a7u7a/AES-Boiler/PCB/board_v1/mfg_image/Board_v1.dxf

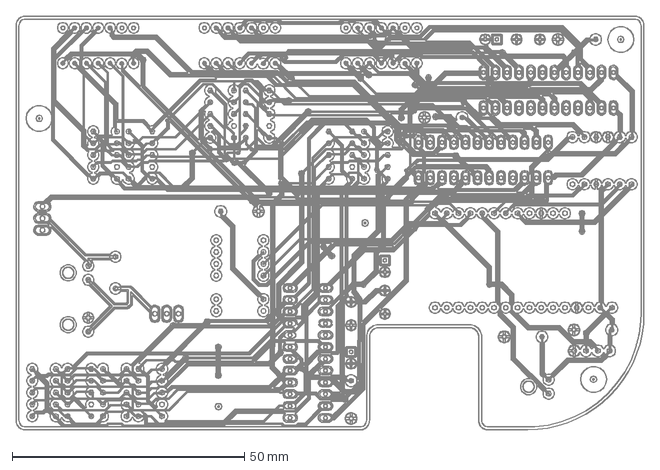
[picture p2: CAD file, 2019-01-08, an earlier design]
PCB/board_v1/mfg_image/Board_v1.dxf
135.1 x 89.0 mm
