a7u7a/AES-Boiler/PCB/board_v1/Board_v1.pdf

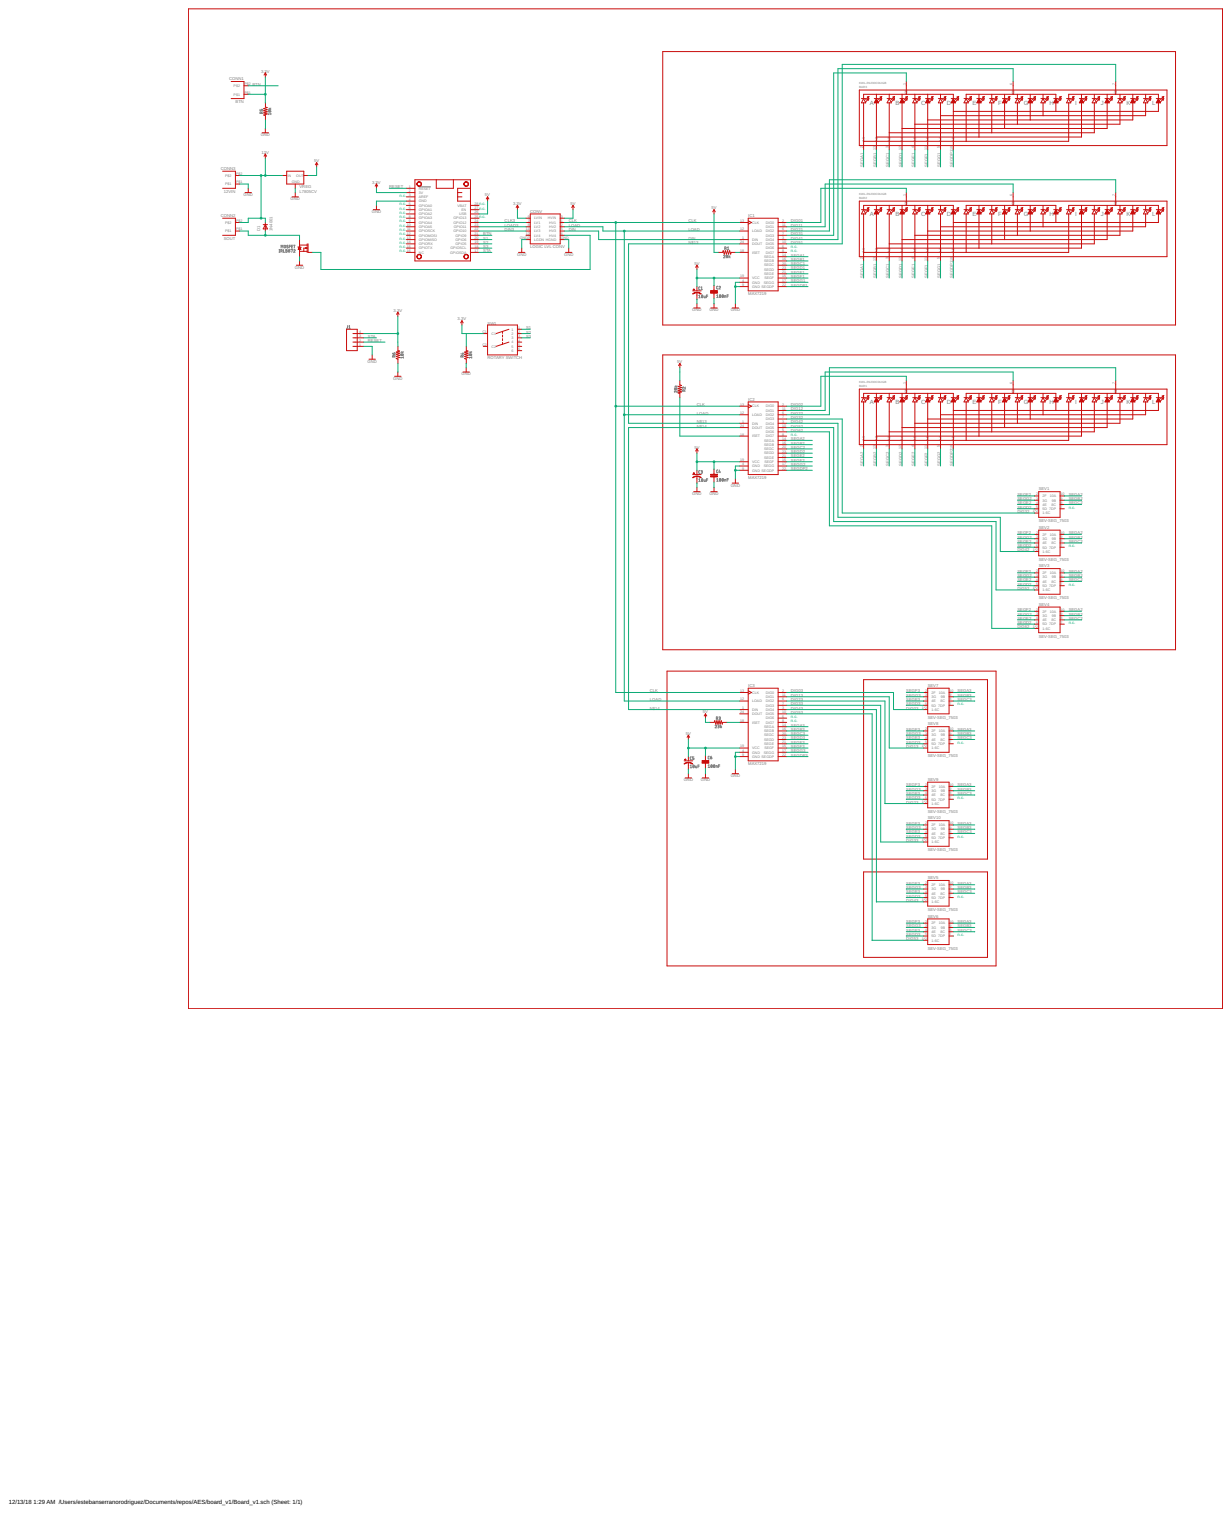
[picture p3: page 1]

N$13 | 24 | 10 DIG6 DIG51
5V | | 5 DIG7 8 SEGA 14 SEGB 16 SEGC 20 SEGD 23 SEGE 21 SEGF 15 SEGG 17 SEGDP

N$14 24 | | 10 DIG6 DIG52

18 | | 5 DIG7 DIG62

12/13/18 1:29 AM /Users/estebanserranorodriguez/Documents/repos/AES/board_v1/Board_v1.sch (Sheet: 1/1)
