a7u7a/AES-Boiler/PCB/board_v2/Board_v2.brd

## EAGLE design PCB/board_v2/Board_v2.brd (2019-01-14)

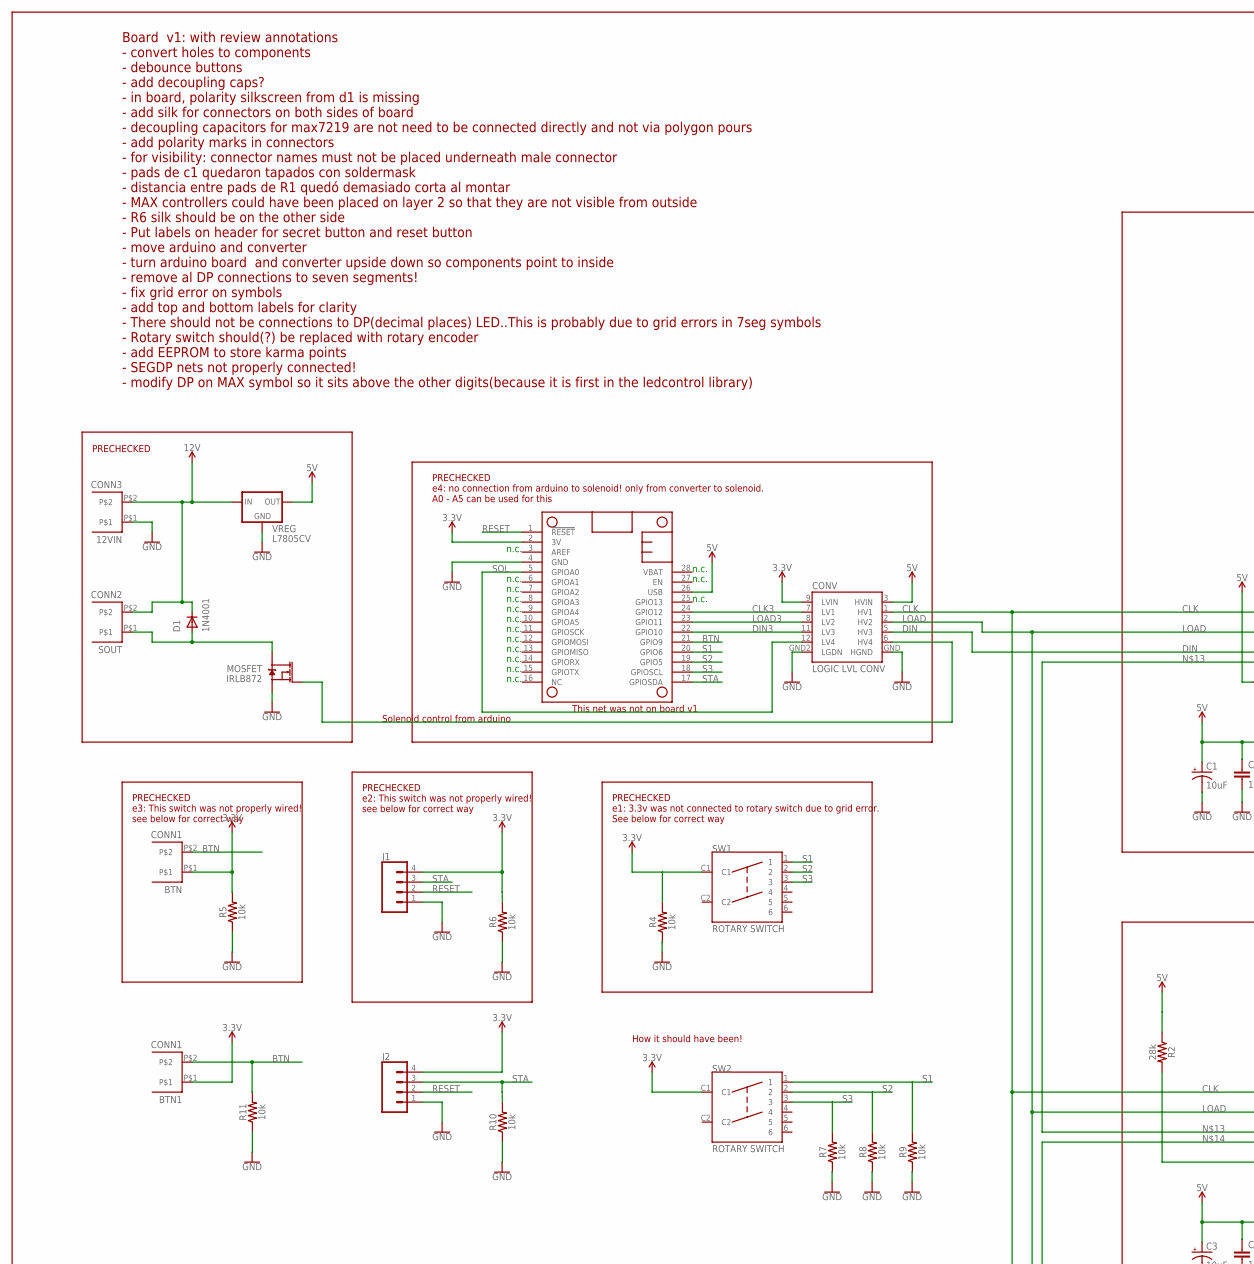
[picture p4: schematic Board_v2.sch, part in row 1, column 1]

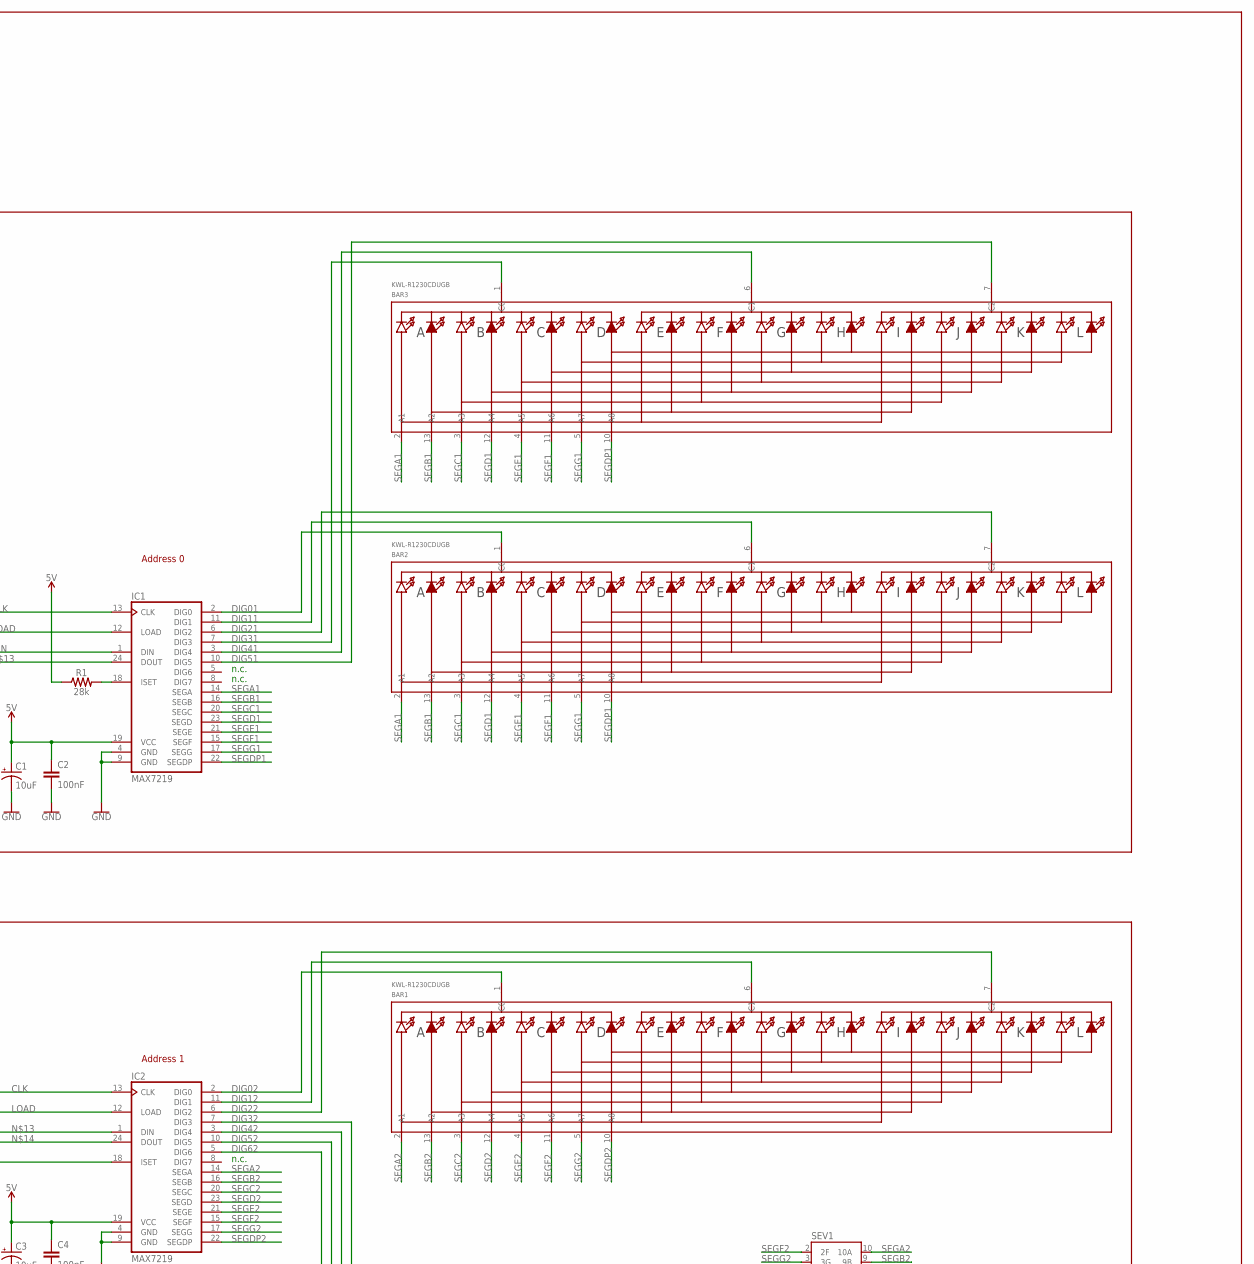
[picture p5: schematic Board_v2.sch, part in row 1, column 2]

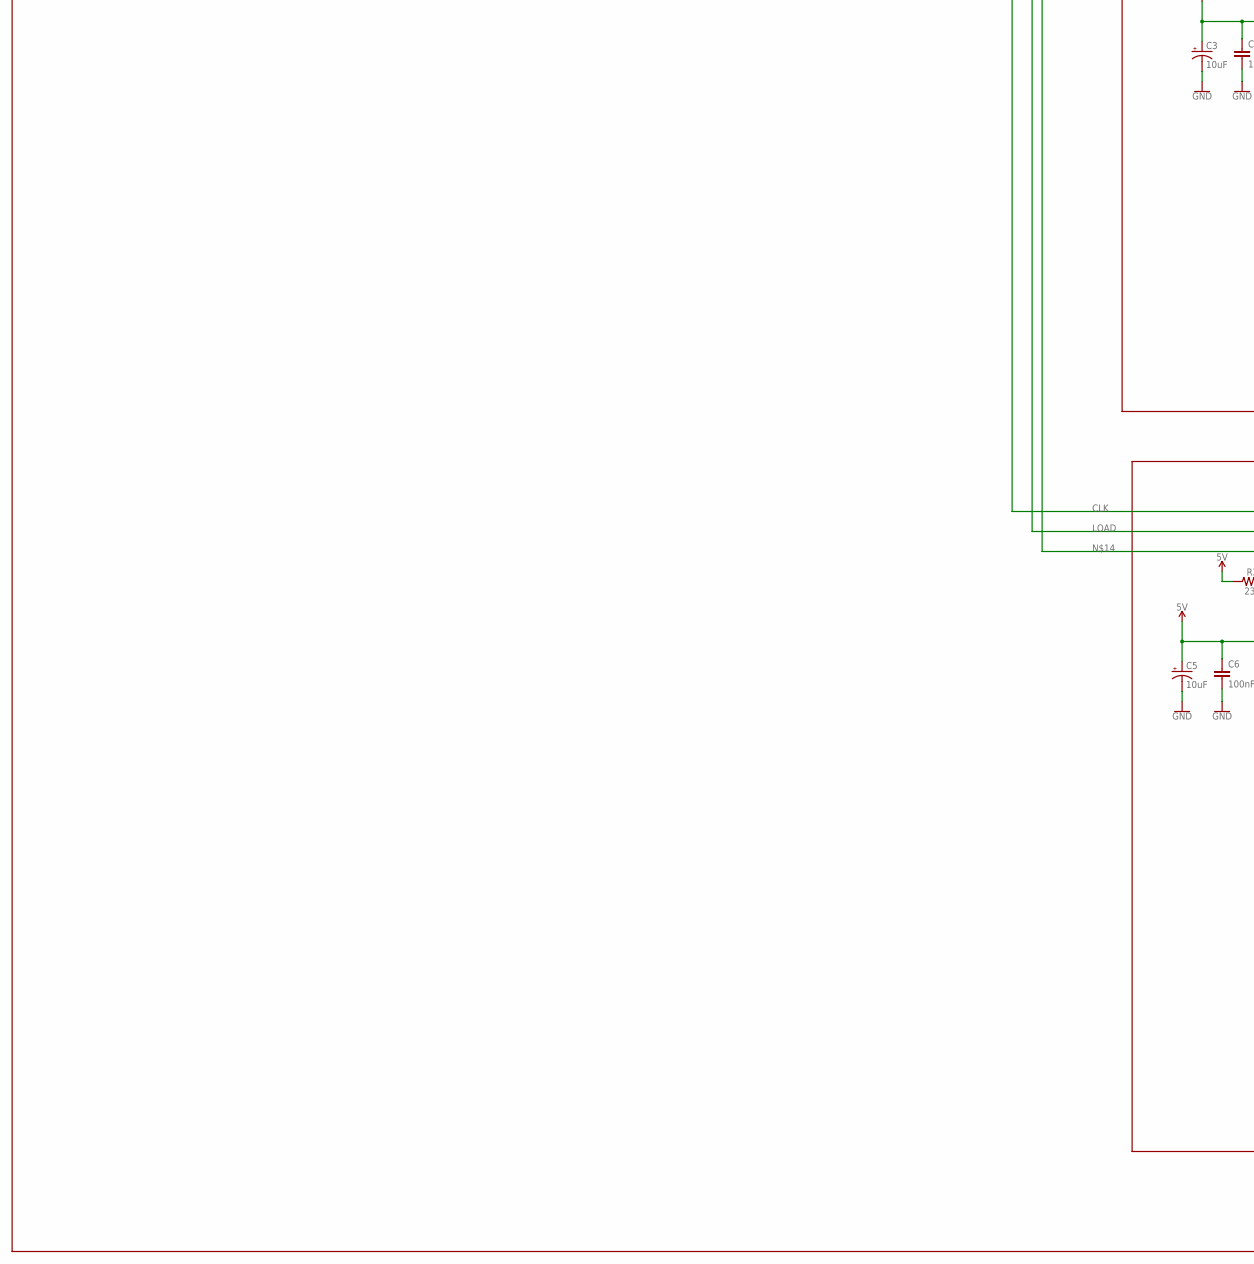
[picture p6: schematic Board_v2.sch, part in row 2, column 1]

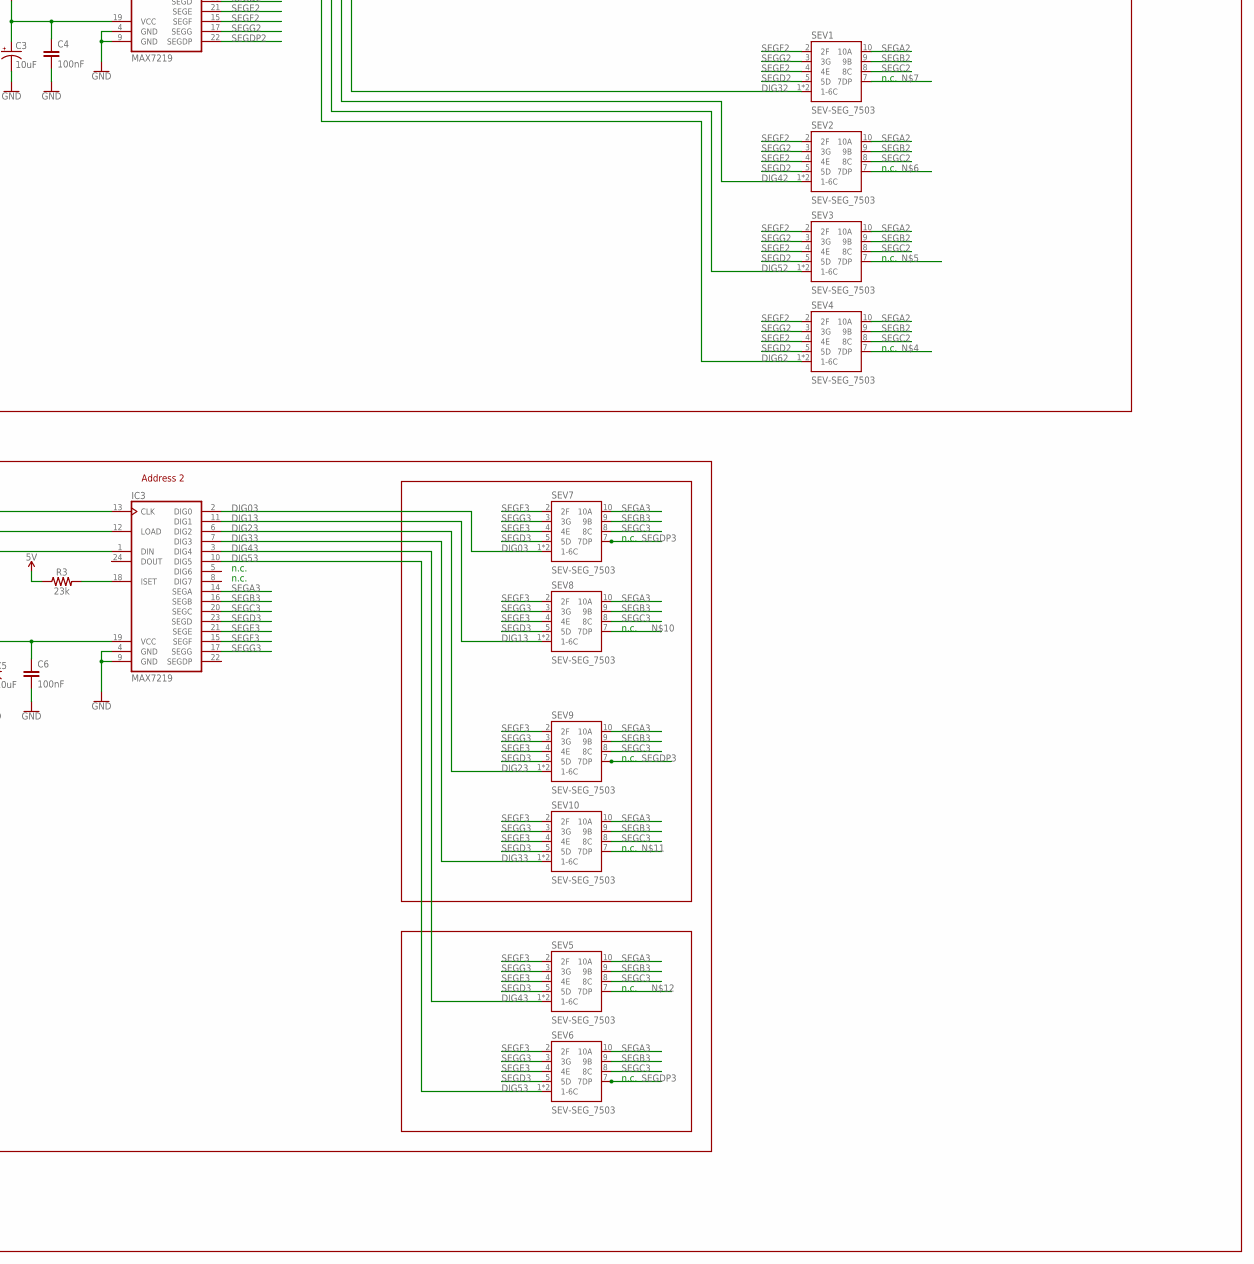
[picture p7: schematic Board_v2.sch, part in row 2, column 2]

Parts:
12VIN: CONN3; MICRO-FIT_43560_3MM
BAR1, BAR2, BAR3: KWL-R1230CDUGB; SEGMENT_BICOL_BL-AR12Z3010
BTN, BTN1: CONN1; MICRO-FIT_43560_3MM
C1, C3, C5: 10uF; CPOL-RADIAL-2.5MM-5MM-KIT
C2, C4, C6: 100nF; CAP-PTH-5MM
CONV: LOGIC LVL CONV; 3-5V_LOGIC_LVL_CONV
D1: 1N4001; CASE59−10-AXIAL
FEATHERM0: FEATHERWING_NODIM; FEATHER
IC1, IC2, IC3: MAX7219; DIL24-3
J1, J2: CONN_041X04_NO_SILK; 1X04_NO_SILK
MOSFET: IRLB872; TO-220-ALT
R1, R2: 28k; AXIAL-0.3
R3: 23k; AXIAL-0.3
R4, R5, R6, R7, R8, R9, R10, R11: 10k; AXIAL-0.3
SEV1, SEV2, SEV3, SEV4, SEV5, SEV6, SEV7, SEV8, SEV9, SEV10: SEV-SEG_7503; HDSP-7503-C
SOUT: CONN2; MICRO-FIT_43560_3MM
SW1, SW2: ROTARY SWITCH; MRB24B_SP3T
VREG: L7805CV; TO-220-ALT

Connections:
3.3V: BTN.P$1, BTN1.P$1, CONV.9 (LVIN), FEATHERM0.2 (3V), J1.4, J2.4, R4.P$2 (2), R5.P$2 (2), R6.P$2 (2), SW1.C1, SW2.C1
5V: C1.1 (+), C2.1, C3.1 (+), C4.1, C5.1 (+), C6.1, CONV.3 (HVIN), FEATHERM0.26 (USB), IC1.19 (VCC), IC2.19 (VCC), IC3.19 (VCC), R1.P$1 (1), R2.P$1 (1), R3.P$1 (1), VREG.OUT
12V: 12VIN.P$2, D1.CAT (C), SOUT.P$2, VREG.IN
BTN: BTN.P$2, BTN1.P$2, FEATHERM0.21 (GPIO9), R11.P$2 (2)
CLK: CONV.1 (HV1), IC1.13 (CLK), IC2.13 (CLK), IC3.13 (CLK)
CLK3: CONV.7 (LV1), FEATHERM0.24 (GPIO12)
DIG01: BAR2.1 (C0), IC1.2 (DIG0)
DIG02: BAR1.1 (C0), IC2.2 (DIG0)
DIG03: IC3.2 (DIG0), SEV7.1 (1-6C), SEV7.6 (1-6C)
DIG11: BAR2.6 (C1), IC1.11 (DIG1)
DIG12: BAR1.6 (C1), IC2.11 (DIG1)
DIG13: IC3.11 (DIG1), SEV8.1 (1-6C), SEV8.6 (1-6C)
DIG21: BAR2.7 (C2), IC1.6 (DIG2)
DIG22: BAR1.7 (C2), IC2.6 (DIG2)
DIG23: IC3.6 (DIG2), SEV9.1 (1-6C), SEV9.6 (1-6C)
DIG31: BAR3.1 (C0), IC1.7 (DIG3)
DIG32: IC2.7 (DIG3), SEV1.1 (1-6C), SEV1.6 (1-6C)
DIG33: IC3.7 (DIG3), SEV10.1 (1-6C), SEV10.6 (1-6C)
DIG41: BAR3.6 (C1), IC1.3 (DIG4)
DIG42: IC2.3 (DIG4), SEV2.1 (1-6C), SEV2.6 (1-6C)
DIG43: IC3.3 (DIG4), SEV5.1 (1-6C), SEV5.6 (1-6C)
DIG51: BAR3.7 (C2), IC1.10 (DIG5)
DIG52: IC2.10 (DIG5), SEV3.1 (1-6C), SEV3.6 (1-6C)
DIG53: IC3.10 (DIG5), SEV6.1 (1-6C), SEV6.6 (1-6C)
DIG62: IC2.5 (DIG6), SEV4.1 (1-6C), SEV4.6 (1-6C)
DIN: CONV.5 (HV3), IC1.1 (DIN)
DIN3: CONV.11 (LV3), FEATHERM0.22 (GPIO10)
GND: 12VIN.P$1, C1.2 (-), C2.2, C3.2 (-), C4.2, C5.2 (-), C6.2, CONV.GND (HGND), CONV.GND2 (LGDN), FEATHERM0.4 (GND), IC1.4 (GND), IC1.9 (GND), IC2.4 (GND), IC2.9 (GND), IC3.4 (GND), IC3.9 (GND), J1.1, J2.1, MOSFET.OUT (S), R4.P$1 (1), R5.P$1 (1), R6.P$1 (1), R7.P$1 (1), R8.P$1 (1), R9.P$1 (1), R10.P$1 (1), R11.P$1 (1), VREG.GND
LOAD: CONV.2 (HV2), IC1.12 (LOAD), IC2.12 (LOAD), IC3.12 (LOAD)
LOAD3: CONV.8 (LV2), FEATHERM0.23 (GPIO11)
unnamed: IC1.18 (ISET), R1.P$2 (2)
unnamed: D1.ANOD (A), MOSFET.GND (D), SOUT.P$1
unnamed: CONV.6 (HV4), MOSFET.IN (G)
unnamed: IC3.18 (ISET), R3.P$2 (2)
unnamed: IC2.18 (ISET), R2.P$2 (2)
unnamed: IC1.24 (DOUT), IC2.1 (DIN)
unnamed: IC2.24 (DOUT), IC3.1 (DIN)
RESET: FEATHERM0.1 (!RESET), J1.2, J2.2
S1: FEATHERM0.20 (GPIO6), R9.P$2 (2), SW1.1, SW2.1
S2: FEATHERM0.19 (GPIO5), R8.P$2 (2), SW1.2, SW2.2
S3: FEATHERM0.18 (GPIOSCL), R7.P$2 (2), SW1.3, SW2.3
SEGA1: BAR2.2 (A1), BAR3.2 (A1), IC1.14 (SEGA)
SEGA2: BAR1.2 (A1), IC2.14 (SEGA), SEV1.10 (10A), SEV2.10 (10A), SEV3.10 (10A), SEV4.10 (10A)
SEGA3: IC3.14 (SEGA), SEV5.10 (10A), SEV6.10 (10A), SEV7.10 (10A), SEV8.10 (10A), SEV9.10 (10A), SEV10.10 (10A)
SEGB1: BAR2.13 (A2), BAR3.13 (A2), IC1.16 (SEGB)
SEGB2: BAR1.13 (A2), IC2.16 (SEGB), SEV1.9 (9B), SEV2.9 (9B), SEV3.9 (9B), SEV4.9 (9B)
SEGB3: IC3.16 (SEGB), SEV5.9 (9B), SEV6.9 (9B), SEV7.9 (9B), SEV8.9 (9B), SEV9.9 (9B), SEV10.9 (9B)
SEGC1: BAR2.3 (A3), BAR3.3 (A3), IC1.20 (SEGC)
SEGC2: BAR1.3 (A3), IC2.20 (SEGC), SEV1.8 (8C), SEV2.8 (8C), SEV3.8 (8C), SEV4.8 (8C)
SEGC3: IC3.20 (SEGC), SEV5.8 (8C), SEV6.8 (8C), SEV7.8 (8C), SEV8.8 (8C), SEV9.8 (8C), SEV10.8 (8C)
SEGD1: BAR2.12 (A4), BAR3.12 (A4), IC1.23 (SEGD)
SEGD2: BAR1.12 (A4), IC2.23 (SEGD), SEV1.5 (5D), SEV2.5 (5D), SEV3.5 (5D), SEV4.5 (5D)
SEGD3: IC3.23 (SEGD), SEV5.5 (5D), SEV6.5 (5D), SEV7.5 (5D), SEV8.5 (5D), SEV9.5 (5D), SEV10.5 (5D)
SEGDP1: BAR2.10 (A8), BAR3.10 (A8), IC1.22 (SEGDP)
SEGDP2: BAR1.10 (A8), IC2.22 (SEGDP)
SEGDP3: SEV6.7 (7DP), SEV7.7 (7DP), SEV9.7 (7DP)
SEGE1: BAR2.4 (A5), BAR3.4 (A5), IC1.21 (SEGE)
SEGE2: BAR1.4 (A5), IC2.21 (SEGE), SEV1.4 (4E), SEV2.4 (4E), SEV3.4 (4E), SEV4.4 (4E)
SEGE3: IC3.21 (SEGE), SEV5.4 (4E), SEV6.4 (4E), SEV7.4 (4E), SEV8.4 (4E), SEV9.4 (4E), SEV10.4 (4E)
SEGF1: BAR2.11 (A6), BAR3.11 (A6), IC1.15 (SEGF)
SEGF2: BAR1.11 (A6), IC2.15 (SEGF), SEV1.2 (2F), SEV2.2 (2F), SEV3.2 (2F), SEV4.2 (2F)
SEGF3: IC3.15 (SEGF), SEV5.2 (2F), SEV6.2 (2F), SEV7.2 (2F), SEV8.2 (2F), SEV9.2 (2F), SEV10.2 (2F)
SEGG1: BAR2.5 (A7), BAR3.5 (A7), IC1.17 (SEGG)
SEGG2: BAR1.5 (A7), IC2.17 (SEGG), SEV1.3 (3G), SEV2.3 (3G), SEV3.3 (3G), SEV4.3 (3G)
SEGG3: IC3.17 (SEGG), SEV5.3 (3G), SEV6.3 (3G), SEV7.3 (3G), SEV8.3 (3G), SEV9.3 (3G), SEV10.3 (3G)
SOL: CONV.12 (LV4), FEATHERM0.5 (GPIOA0)
STA: FEATHERM0.17 (GPIOSDA), J1.3, J2.3, R10.P$2 (2)

Notes on the sheet:
n.c.
PRECHECKED e1: 3.3v was not connected to rotary switch due to grid error. See below for correct way
Board v1: with review annotations - convert holes to components - debounce buttons - add decoupling caps? - in board, polarity silkscreen from d1 is missing - add silk for connectors on both sides of board - decoupling capacitors for max7219 are not need to be connected directly and not via polygon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
PRECHECKED e2: This switch was not properly wired! see below for correct way
PRECHECKED
Solenoid control from arduino
PRECHECKED e4: no connection from arduino to solenoid! only from converter to solenoid. A0 - A5 can be used for this
How it should have been!
PRECHECKED e3: This switch was not properly wired! see below for correct way
This net was not on board v1
Address 0
Address 1
Address 2

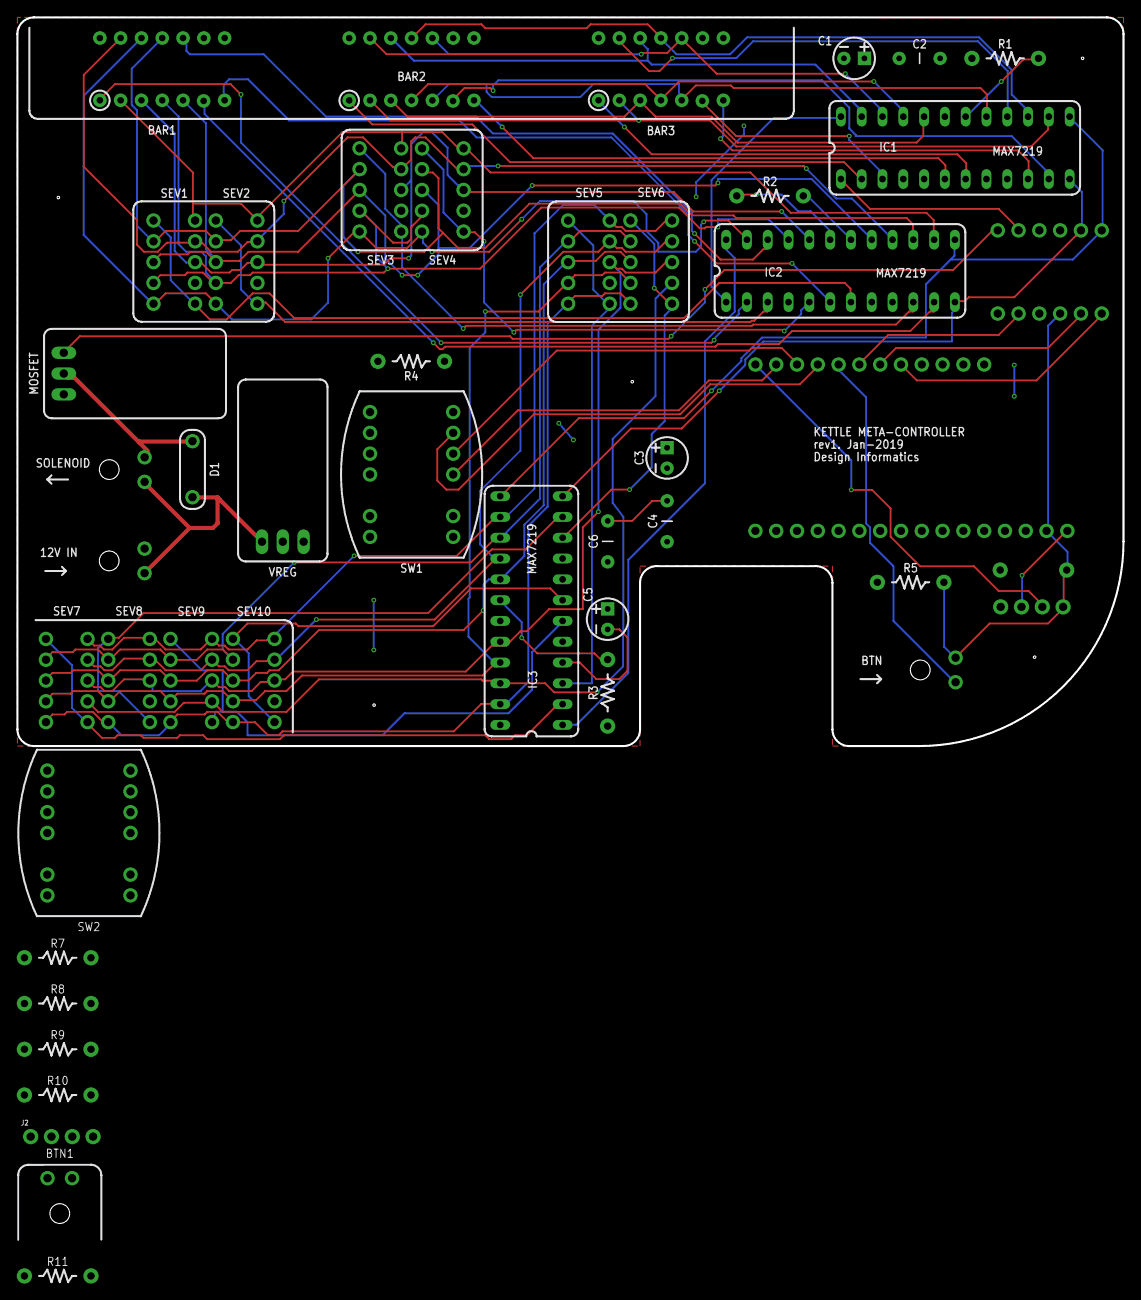
[picture p8: board Board_v2.brd from above]

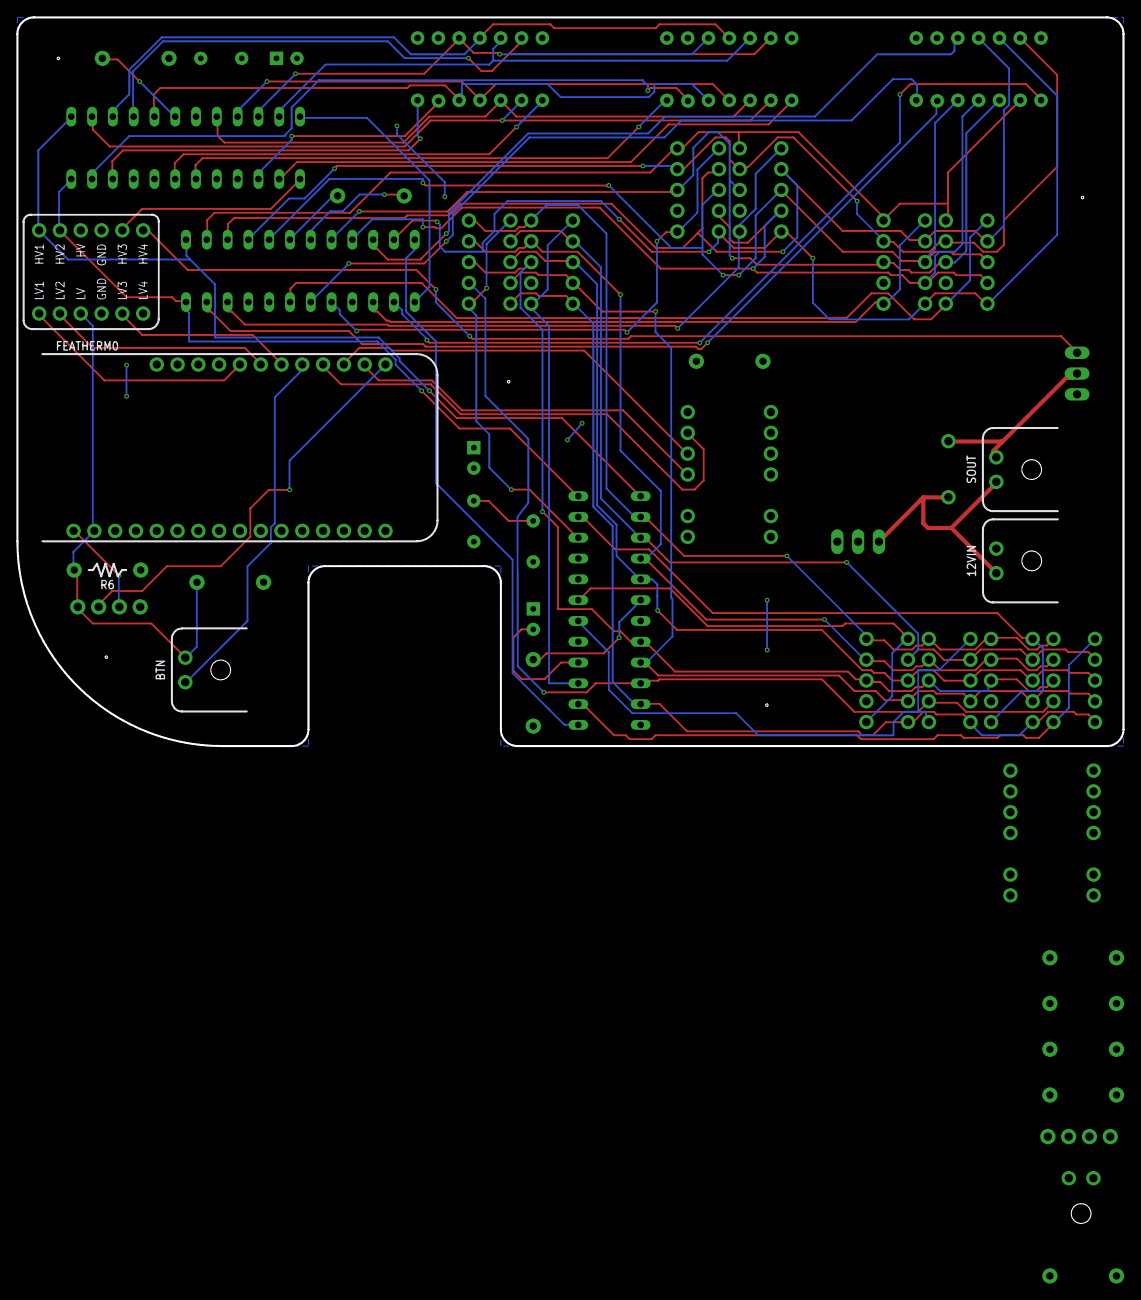
[picture p9: board Board_v2.brd from below]

Board: 2 copper layers, 135.1 x 89.0 mm, 46 parts (6 on the bottom side), 67 nets.
