a7u7a/AES-Boiler/src/bars_displayval/bars_displayval.ino

// Address bar graph individually
// todo: create function that takes a value and a color and displays the value in the specified color. Similar to printNum function

//We always have to include the library
#include "LedControl.h"

 // Set pins and number of devices
 // Arguments: LedControl(dataPin,clockPin,csPin,numDevices)
LedControl lc = LedControl(10, 12, 11, 3);

int barGreen[36][3] = {{1,0,2},{1,0,4},{1,0,6},{1,0,0},{1,1,2},{1,1,4},{1,1,6},{1,1,0},{1,2,2},{1,2,4},{1,2,6},{1,2,0},{0,0,2},{0,0,4},{0,0,6},{0,0,0},{0,1,2},{0,1,4},{0,1,6},{0,1,0},{0,2,2},{0,2,4},{0,2,6},{0,2,0},{0,3,2},{0,3,4},{0,3,6},{0,3,0},{0,4,2},{0,4,4},{0,4,6},{0,4,0},{0,5,2},{0,5,4},{0,5,6},{0,5,0}};
int barRed[36][3] = {{1,0,1},{1,0,3},{1,0,5},{1,0,7},{1,1,1},{1,1,3},{1,1,5},{1,1,7},{1,2,1},{1,2,3},{1,2,5},{1,2,7},{0,0,1},{0,0,3},{0,0,5},{0,0,7},{0,1,1},{0,1,3},{0,1,5},{0,1,7},{0,2,1},{0,2,3},{0,2,5},{0,2,7},{0,3,1},{0,3,3},{0,3,5},{0,3,7},{0,4,1},{0,4,3},{0,4,5},{0,4,7},{0,5,1},{0,5,3},{0,5,5},{0,5,7}};

// Rotary switch pins
const int S1 = 6;
const int S2 = 5;
const int S3 = 21; // Also labeled 'SCL' on the Feather

// Button pins
const int usrBtnPin = 9; // User button
const int staBtnPin = 20; // State change button. Pin also labeled 'SDA' on the Feather

int usrBtnState = 0;
int staBtnState = 0;

// Solenoid pin
int solenoidPin = A0;

int wait = 50;
unsigned long delaytime = 50;




void setup() {
  Serial.begin(9600);
  delay(1000);
  Serial.println("Kettle controller booting up!");

  // Initialize pins
  pinMode(LED_BUILTIN, OUTPUT);
  pinMode(solenoidPin, OUTPUT);
  digitalWrite(solenoidPin, LOW);
  pinMode(S1, INPUT);
  pinMode(S2, INPUT);
  pinMode(S3, INPUT);
  pinMode(usrBtnPin, INPUT);
  pinMode(staBtnPin, INPUT);

  // Initialize display drivers
  int devices = lc.getDeviceCount();
  for (int address = 0; address < devices; address++) {
    /*The MAX72XX is in power-saving mode on startup*/
    lc.shutdown(address, false);
    /* Set the brightness to a medium values */
    lc.setIntensity(address, 15);
    /* and clear the display */
    lc.clearDisplay(address);
  }
}

void loop() {
  int devices = lc.getDeviceCount();
  for (int pos=0;pos<36;pos++){
    lc.setLed(barGreen[pos][0],barGreen[pos][1],barGreen[pos][2],true);
    delay(10);
  }
  // Clear display
for(int address=0;address<devices;address++) {
    lc.clearDisplay(address);
  }
  for (int pos=0;pos<36;pos++){
    lc.setLed(barRed[pos][0],barRed[pos][1],barRed[pos][2],true);
    delay(10);
  }
  // Clear display
for(int address=0;address<devices;address++) {
    lc.clearDisplay(address);
}
}


  
  /*
  // Iterate over MAX devices
  for(int address=0;address<1;address++) {
    // Iterate over rows(Digits)
    for(int row=0;row<8;row++) {
      // Iterate over columns(Segments)
      for(int col=0;col<8;col++) {
        lc.setLed(address,row,col,true);
        delay(delaytime);
      }
    }
}


// Clear display
for(int address=0;address<devices;address++) {
    lc.clearDisplay(address);
  }
}

/* Set the status of a single Led.
 * Params :
 *   addr  address of the display
 *   row   the row of the Led (0..7)
 *   col   the column of the Led (0..7)
 *   state If true the led is switched on, if false it is switched off 
 *   void setLed(int addr, int row(digit), int col(segment), boolean state); 
*/ 
