a7u7a/AES-Boiler/(commit log)

2018-12-11 added arduino code
2018-12-11 PCB v1 WIP
    [Board_v1.brd, Board_v1.sch]
2018-12-12 added button pcb
    [Board_v1.brd, Board_v1.sch, button_pcb_v1.brd, button_pcb_v1.sch]
2018-12-12 ready to start routing?
    [Board_v1.brd, Board_v1.sch]
2018-12-12 routing v1 finish
    [Board_v1.brd, Board_v1.sch]
2018-12-13 ready for fabhouse v1
    [BOM_Board_v1.csv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]
2018-12-13 added CAM files for button board
    [button_pcb_v1.GBL, button_pcb_v1.GBO, button_pcb_v1.GBP, button_pcb_v1.GBS, button_pcb_v1.GTL, button_pcb_v1.GTO, button_pcb_v1.GTP, button_pcb_v1.GTS]
2019-01-04 added board v2 files with annotations from board v1
    [Board_v2.brd, Board_v2.sch]
2019-01-07 added precheck marks on board-v2
2019-01-07 more corrections to board v2: new rotary switch connection in schematic
    [DemoCascadedDevices.ino, rotaryswitch_test.ino]
2019-01-08 added 'mfg_image'
    [Board_v1.dxf, Board_v1_bottom.dxf]
2019-01-08 more pull down updates
    [Board_v1.sch, Board_v2.sch]
2019-01-09 new annotations to boardv2 files
    [Board_v2.brd, Board_v2.sch]
2019-01-09 boardv2 files annotated with new found errors
    [Board_v2.brd, Board_v2.sch]
2019-01-09 renamed 'Firmware' folder to 'AES_Boiler_Firmware'
    [Board_v2.sch]
2019-01-10 started working on firmware, initial versions of full power test
2019-01-10 working version of full power test
    [Board_v2.brd]
2019-01-10 selector leds working with rotary switch
    [Board_v2.sch]
2019-01-11 added fade test sketch
    [Board_v2.sch]
2019-01-11 more annotations to eagle file board_v2
    [Board_v2.sch]
2019-01-14 changed code folder to src, preparing to separate pcb and code into separate repos. added interrupt_test1.ino
2019-01-14 functional version of bars_displayval.ino
    [Board_v2.brd, Board_v2.sch]
2019-01-16 rearragned folders
    [BOM_Board_v1.csv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]
2019-01-18 added solenoid control to boil water
2019-01-18 added gridChange_v1.ino to test timer on state change
2019-01-18 interrupt for state change test
2019-01-19 loop_test1.ino as used in BRE, added bug mode files
    [gridChange_interrupt_v1.ino, loop_test1_bugmode.ino]
2019-01-22 updated pcbv2
